idoarad99-jpg/Stickeep-IOT/Documentation/Edge_Cases_List.docx

# Stickeep – רשימת מקרי קצה

רשימת תרחישי קצה שהפרויקט (אפליקציית Flutter + Firebase + חומרת ESP32 עם אישור הגעה ב-NFC/QR) יודע לטפל בהם, כפי שנבדקו לקראת ההגשה הסופית.

# | תרחיש | תוצאה מצופה

1 | ביטול הזמנה שכרגע פעילה על מסך המכשיר (מצב QR/Reserved) | המכשיר חוזר למסך פנוי/idle תוך כ-10 שניות — לא נשאר תקוע על ההזמנה המבוטלת
2 | סריקת כרטיס NFC שגוי (לא תואם להזמנה) | מסך אדום "Card not recognized" למשך 1.5 שניות, ואז חזרה למסך ה-QR — בלי קריסה
3 | סריקת אותו כרטיס NFC פעמיים תוך פחות מ-3 שניות | הסריקה השנייה לא גורמת לקריאה כפולה ל-Cloud Function (cooldown פנימי)
4 | שתי הזמנות סמוכות לאותו מושב (למשל 10:00-11:00 ואז 11:00-12:00) | המכשיר עובר בצורה חלקה בין ההזמנות ב-11:00 — בלי רגע ביניים שמראה "פנוי"
5 | הזמנה שמתחילה תוך 15 דקות אך טרם הגיע זמנה הרשמי | המכשיר כבר מציג QR/Reserved לפני שעת ההתחלה הרשמית (בדיקת חלון הזמן המוקדם)
6 | זמן ההזמנה מסתיים בלי שהסטודנט הגיע | המכשיר חוזר אוטומטית למסך פנוי
7 | ניתוק WiFi בדיוק בזמן ניסיון אישור NFC | ה-Serial Monitor מציג "no WiFi", המסך לא נתקע, ואפשר לנסות שוב לאחר שהחיבור חוזר
8 | הענן לא זמין / שגיאת 500 מה-Cloud Function בזמן אישור | המכשיר מציג הודעת "לא מזוהה" בצורה מבוקרת, בלי קריסה
9 | מפתח API שגוי/לא תקין (401 Unauthorized) | המכשיר מתנהג כמו כרטיס לא תואם — ההודעה למשתמש עדיין הגיונית
10 | הדלקת המכשיר כשאין בכלל חיבור WiFi זמין | לא נתקע לצמיתות, מציג סטטוס "לא מחובר", וממשיך לנסות להתחבר
11 | מספר מושבים/מכשירים בו-זמנית | לכל מכשיר SEAT_ID שונה — אין ערבוב הזמנות בין מכשירים
12 | לחיצה על כפתור העקיפה הידני (test button) במסך QR | מעבר מקומי בלבד למסך "תודה" — בלי קריאה ל-Cloud Function ובלי שינוי סטטוס ב-RTDB/Firestore (לצורכי הדגמה בלבד)
