idoarad99-jpg/Stickeep-IOT/stickeep_app/flutter_01.png

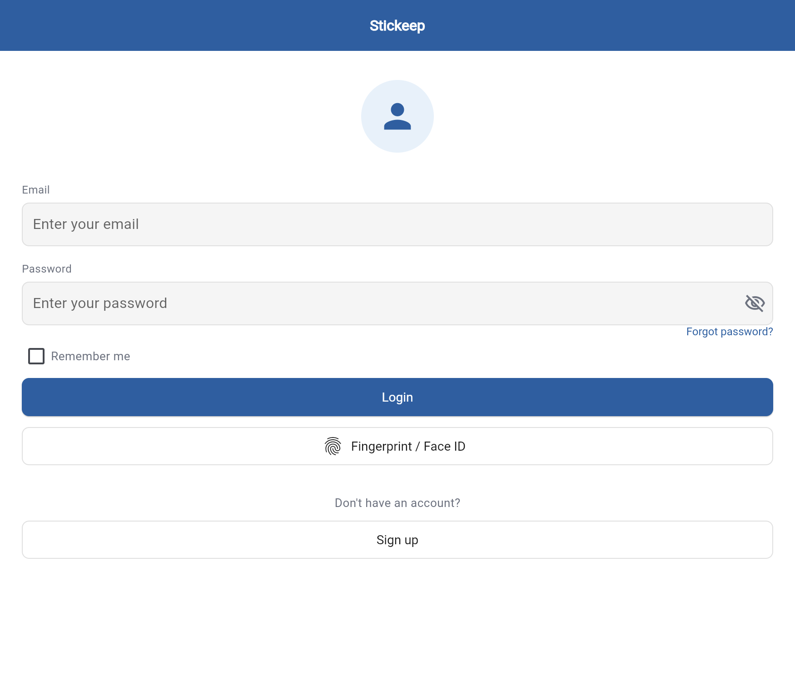
stickeep_app/flutter_01.png
