idoarad99-jpg/Stickeep-IOT/ESP32/QR_image.h

// array size is 10884
static const byte QR_image[] PROGMEM  = {
  0xff, 0xd8, 0xff, 0xe0, 0x00, 0x10, 0x4a, 0x46, 0x49, 0x46, 0x00, 0x01, 0x01, 0x01, 0x01, 0x4a, 
  0x01, 0x4a, 0x00, 0x00, 0xff, 0xdb, 0x00, 0x43, 0x00, 0x03, 0x02, 0x02, 0x02, 0x02, 0x02, 0x03, 
  0x02, 0x02, 0x02, 0x03, 0x03, 0x03, 0x03, 0x04, 0x06, 0x04, 0x04, 0x04, 0x04, 0x04, 0x08, 0x06, 
  0x06, 0x05, 0x06, 0x09, 0x08, 0x0a, 0x0a, 0x09, 0x08, 0x09, 0x09, 0x0a, 0x0c, 0x0f, 0x0c, 0x0a, 
  0x0b, 0x0e, 0x0b, 0x09, 0x09, 0x0d, 0x11, 0x0d, 0x0e, 0x0f, 0x10, 0x10, 0x11, 0x10, 0x0a, 0x0c, 
  0x12, 0x13, 0x12, 0x10, 0x13, 0x0f, 0x10, 0x10, 0x10, 0xff, 0xdb, 0x00, 0x43, 0x01, 0x03, 0x03, 
  0x03, 0x04, 0x03, 0x04, 0x08, 0x04, 0x04, 0x08, 0x10, 0x0b, 0x09, 0x0b, 0x10, 0x10, 0x10, 0x10, 
  0x10, 0x10, 0x10, 0x10, 0x10, 0x10, 0x10, 0x10, 0x10, 0x10, 0x10, 0x10, 0x10, 0x10, 0x10, 0x10, 
  0x10, 0x10, 0x10, 0x10, 0x10, 0x10, 0x10, 0x10, 0x10, 0x10, 0x10, 0x10, 0x10, 0x10, 0x10, 0x10, 
  0x10, 0x10, 0x10, 0x10, 0x10, 0x10, 0x10, 0x10, 0x10, 0x10, 0x10, 0x10, 0x10, 0x10, 0xff, 0xc0, 
  0x00, 0x11, 0x08, 0x00, 0x88, 0x00, 0xf0, 0x03, 0x01, 0x22, 0x00, 0x02, 0x11, 0x01, 0x03, 0x11, 
  0x01, 0xff, 0xc4, 0x00, 0x1d, 0x00, 0x01, 0x00, 0x03, 0x01, 0x00, 0x03, 0x01, 0x01, 0x00, 0x00, 
  0x00, 0x00, 0x00, 0x00, 0x00, 0x00, 0x00, 0x06, 0x07, 0x08, 0x05, 0x01, 0x04, 0x09, 0x03, 0x02, 
  0xff, 0xc4, 0x00, 0x56, 0x10, 0x00, 0x00, 0x04, 0x05, 0x02, 0x02, 0x03, 0x0a, 0x0a, 0x06, 0x06, 
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
  0xbd, 0x56, 0x96, 0x26, 0xa9, 0x93, 0xdc, 0x11, 0xb8, 0xb2, 0x9a, 0x8e, 0x9f, 0x59, 0xe3, 0xd9, 
  0x8c, 0xc5, 0x67, 0xcd, 0x26, 0x12, 0xa5, 0x16, 0x40, 0x8d, 0xdf, 0x12, 0x5b, 0xc6, 0xe0, 0x89, 
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
};
