idoarad99-jpg/Stickeep-IOT/ESP32/Reserved.h

// array size is 8305
static const byte Reserved[] PROGMEM  = {
  0xff, 0xd8, 0xff, 0xe0, 0x00, 0x10, 0x4a, 0x46, 0x49, 0x46, 0x00, 0x01, 0x01, 0x01, 0x01, 0x4a, 
  0x01, 0x4a, 0x00, 0x00, 0xff, 0xdb, 0x00, 0x43, 0x00, 0x03, 0x02, 0x02, 0x02, 0x02, 0x02, 0x03, 
  0x02, 0x02, 0x02, 0x03, 0x03, 0x03, 0x03, 0x04, 0x06, 0x04, 0x04, 0x04, 0x04, 0x04, 0x08, 0x06, 
  0x06, 0x05, 0x06, 0x09, 0x08, 0x0a, 0x0a, 0x09, 0x08, 0x09, 0x09, 0x0a, 0x0c, 0x0f, 0x0c, 0x0a, 
  0x0b, 0x0e, 0x0b, 0x09, 0x09, 0x0d, 0x11, 0x0d, 0x0e, 0x0f, 0x10, 0x10, 0x11, 0x10, 0x0a, 0x0c, 
  0x12, 0x13, 0x12, 0x10, 0x13, 0x0f, 0x10, 0x10, 0x10, 0xff, 0xdb, 0x00, 0x43, 0x01, 0x03, 0x03, 
  0x03, 0x04, 0x03, 0x04, 0x08, 0x04, 0x04, 0x08, 0x10, 0x0b, 0x09, 0x0b, 0x10, 0x10, 0x10, 0x10, 
  0x10, 0x10, 0x10, 0x10, 0x10, 0x10, 0x10, 0x10, 0x10, 0x10, 0x10, 0x10, 0x10, 0x10, 0x10, 0x10, 
  0x10, 0x10, 0x10, 0x10, 0x10, 0x10, 0x10, 0x10, 0x10, 0x10, 0x10, 0x10, 0x10, 0x10, 0x10, 0x10, 
  0x10, 0x10, 0x10, 0x10, 0x10, 0x10, 0x10, 0x10, 0x10, 0x10, 0x10, 0x10, 0x10, 0x10, 0xff, 0xc0, 
  0x00, 0x11, 0x08, 0x00, 0x88, 0x00, 0xf0, 0x03, 0x01, 0x22, 0x00, 0x02, 0x11, 0x01, 0x03, 0x11, 
  0x01, 0xff, 0xc4, 0x00, 0x1d, 0x00, 0x01, 0x00, 0x02, 0x02, 0x03, 0x01, 0x01, 0x00, 0x00, 0x00, 
  0x00, 0x00, 0x00, 0x00, 0x00, 0x00, 0x00, 0x06, 0x07, 0x05, 0x08, 0x01, 0x03, 0x04, 0x09, 0x02, 
  0xff, 0xc4, 0x00, 0x57, 0x10, 0x00, 0x01, 0x03, 0x03, 0x02, 0x03, 0x01, 0x0a, 0x09, 0x07, 0x06, 
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
  0xc5, 0x0c, 0x07, 0x1b, 0x09, 0x59, 0x43, 0xee, 0x92, 0xad, 0x82, 0x10, 0x9c, 0xa5, 0xbf, 0x42, 
  0x32, 0x9b, 0x16, 0xa0, 0xa7, 0x50, 0x6d, 0x39, 0x1d, 0x81, 0xf9, 0x13, 0x2e, 0x37, 0x37, 0x67, 
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
};
