idoarad99-jpg/Stickeep-IOT/ESP32/Thank_you.h

// array size is 11939
static const byte Thank_you[] PROGMEM  = {
  0xff, 0xd8, 0xff, 0xe0, 0x00, 0x10, 0x4a, 0x46, 0x49, 0x46, 0x00, 0x01, 0x01, 0x01, 0x01, 0x4a, 
  0x01, 0x4a, 0x00, 0x00, 0xff, 0xdb, 0x00, 0x43, 0x00, 0x03, 0x02, 0x02, 0x02, 0x02, 0x02, 0x03, 
  0x02, 0x02, 0x02, 0x03, 0x03, 0x03, 0x03, 0x04, 0x06, 0x04, 0x04, 0x04, 0x04, 0x04, 0x08, 0x06, 
  0x06, 0x05, 0x06, 0x09, 0x08, 0x0a, 0x0a, 0x09, 0x08, 0x09, 0x09, 0x0a, 0x0c, 0x0f, 0x0c, 0x0a, 
  0x0b, 0x0e, 0x0b, 0x09, 0x09, 0x0d, 0x11, 0x0d, 0x0e, 0x0f, 0x10, 0x10, 0x11, 0x10, 0x0a, 0x0c, 
  0x12, 0x13, 0x12, 0x10, 0x13, 0x0f, 0x10, 0x10, 0x10, 0xff, 0xdb, 0x00, 0x43, 0x01, 0x03, 0x03, 
  0x03, 0x04, 0x03, 0x04, 0x08, 0x04, 0x04, 0x08, 0x10, 0x0b, 0x09, 0x0b, 0x10, 0x10, 0x10, 0x10, 
  0x10, 0x10, 0x10, 0x10, 0x10, 0x10, 0x10, 0x10, 0x10, 0x10, 0x10, 0x10, 0x10, 0x10, 0x10, 0x10, 
  0x10, 0x10, 0x10, 0x10, 0x10, 0x10, 0x10, 0x10, 0x10, 0x10, 0x10, 0x10, 0x10, 0x10, 0x10, 0x10, 
  0x10, 0x10, 0x10, 0x10, 0x10, 0x10, 0x10, 0x10, 0x10, 0x10, 0x10, 0x10, 0x10, 0x10, 0xff, 0xc0, 
  0x00, 0x11, 0x08, 0x00, 0x87, 0x00, 0xf0, 0x03, 0x01, 0x22, 0x00, 0x02, 0x11, 0x01, 0x03, 0x11, 
  0x01, 0xff, 0xc4, 0x00, 0x1d, 0x00, 0x00, 0x02, 0x03, 0x00, 0x03, 0x01, 0x01, 0x00, 0x00, 0x00, 
  0x00, 0x00, 0x00, 0x00, 0x00, 0x00, 0x00, 0x08, 0x05, 0x06, 0x07, 0x01, 0x02, 0x04, 0x03, 0x09, 
  0xff, 0xc4, 0x00, 0x57, 0x10, 0x00, 0x01, 0x03, 0x03, 0x02, 0x03, 0x03, 0x05, 0x0b, 0x07, 0x08, 
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
  0x05, 0x05, 0x25, 0x01, 0x25, 0x00, 0x2f, 0xb4, 0xe8, 0xf6, 0xc2, 0x5d, 0xe9, 0xba, 0x59, 0xdc, 
  0x48, 0x77, 0x5d, 0xba, 0x2e, 0x13, 0x31, 0x12, 0x64, 0x47, 0x93, 0x45, 0x71, 0xda, 0x76, 0x17, 
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
};
