idoarad99-jpg/Stickeep-IOT/Unit Tests/Image display/IOT_Chair/Main_screen135x240.h

// array size is 6058
static const byte Main_screen135x240[] PROGMEM  = {
  0xff, 0xd8, 0xff, 0xe0, 0x00, 0x10, 0x4a, 0x46, 0x49, 0x46, 0x00, 0x01, 0x01, 0x00, 0x00, 0x01, 
  0x00, 0x01, 0x00, 0x00, 0xff, 0xe2, 0x01, 0xd8, 0x49, 0x43, 0x43, 0x5f, 0x50, 0x52, 0x4f, 0x46, 
  0x49, 0x4c, 0x45, 0x00, 0x01, 0x01, 0x00, 0x00, 0x01, 0xc8, 0x00, 0x00, 0x00, 0x00, 0x04, 0x30, 
  0x00, 0x00, 0x6d, 0x6e, 0x74, 0x72, 0x52, 0x47, 0x42, 0x20, 0x58, 0x59, 0x5a, 0x20, 0x07, 0xe0, 
  0x00, 0x01, 0x00, 0x01, 0x00, 0x00, 0x00, 0x00, 0x00, 0x00, 0x61, 0x63, 0x73, 0x70, 0x00, 0x00, 
  0x00, 0x00, 0x00, 0x00, 0x00, 0x00, 0x00, 0x00, 0x00, 0x00, 0x00, 0x00, 0x00, 0x00, 0x00, 0x00, 
  0x00, 0x00, 0x00, 0x00, 0x00, 0x00, 0x00, 0x00, 0x00, 0x01, 0x00, 0x00, 0xf6, 0xd6, 0x00, 0x01, 
  0x00, 0x00, 0x00, 0x00, 0xd3, 0x2d, 0x00, 0x00, 0x00, 0x00, 0x00, 0x00, 0x00, 0x00, 0x00, 0x00, 
  0x00, 0x00, 0x00, 0x00, 0x00, 0x00, 0x00, 0x00, 0x00, 0x00, 0x00, 0x00, 0x00, 0x00, 0x00, 0x00, 
  0x00, 0x00, 0x00, 0x00, 0x00, 0x00, 0x00, 0x00, 0x00, 0x00, 0x00, 0x00, 0x00, 0x00, 0x00, 0x00, 
  0x00, 0x00, 0x00, 0x00, 0x00, 0x00, 0x00, 0x00, 0x00, 0x09, 0x64, 0x65, 0x73, 0x63, 0x00, 0x00, 
  0x00, 0xf0, 0x00, 0x00, 0x00, 0x24, 0x72, 0x58, 0x59, 0x5a, 0x00, 0x00, 0x01, 0x14, 0x00, 0x00, 
  0x00, 0x14, 0x67, 0x58, 0x59, 0x5a, 0x00, 0x00, 0x01, 0x28, 0x00, 0x00, 0x00, 0x14, 0x62, 0x58, 
  0x59, 0x5a, 0x00, 0x00, 0x01, 0x3c, 0x00, 0x00, 0x00, 0x14, 0x77, 0x74, 0x70, 0x74, 0x00, 0x00, 
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
  0x4f, 0x4f, 0x4f, 0x4f, 0x4f, 0x4f, 0x4f, 0x4f, 0x4f, 0x4f, 0x4f, 0x4f, 0x4f, 0x4f, 0x4f, 0x4f, 
  0x4f, 0x4f, 0x4f, 0x4f, 0x4f, 0x4f, 0x4f, 0x4f, 0xff, 0xc0, 0x00, 0x11, 0x08, 0x00, 0x87, 0x00, 
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
};
