idoarad99-jpg/Stickeep-IOT/Unit Tests/Image display/IOT_Chair/jpeg5.h

// array size is 6734
static const byte northn_lights[] PROGMEM  = {
  0xff, 0xd8, 0xff, 0xe0, 0x00, 0x10, 0x4a, 0x46, 0x49, 0x46, 0x00, 0x01, 0x01, 0x01, 0x00, 0x60, 
  0x00, 0x60, 0x00, 0x00, 0xff, 0xe1, 0x0b, 0xf6, 0x45, 0x78, 0x69, 0x66, 0x00, 0x00, 0x4d, 0x4d, 
  0x00, 0x2a, 0x00, 0x00, 0x00, 0x08, 0x00, 0x01, 0x01, 0x12, 0x00, 0x03, 0x00, 0x00, 0x00, 0x01, 
  0x00, 0x01, 0x00, 0x00, 0x00, 0x00, 0x00, 0x1a, 0x00, 0x06, 0x01, 0x03, 0x00, 0x03, 0x00, 0x00, 
  0x00, 0x01, 0x00, 0x06, 0x00, 0x00, 0x01, 0x1a, 0x00, 0x05, 0x00, 0x00, 0x00, 0x01, 0x00, 0x00, 
  0x00, 0x68, 0x01, 0x1b, 0x00, 0x05, 0x00, 0x00, 0x00, 0x01, 0x00, 0x00, 0x00, 0x70, 0x01, 0x28, 
  0x00, 0x03, 0x00, 0x00, 0x00, 0x01, 0x00, 0x02, 0x00, 0x00, 0x02, 0x01, 0x00, 0x04, 0x00, 0x00, 
  0x00, 0x01, 0x00, 0x00, 0x00, 0x78, 0x02, 0x02, 0x00, 0x04, 0x00, 0x00, 0x00, 0x01, 0x00, 0x00, 
  0x0b, 0x75, 0x00, 0x00, 0x00, 0x00, 0x00, 0x00, 0x00, 0x60, 0x00, 0x00, 0x00, 0x01, 0x00, 0x00, 
  0x00, 0x60, 0x00, 0x00, 0x00, 0x01, 0xff, 0xd8, 0xff, 0xdb, 0x00, 0x43, 0x00, 0x08, 0x06, 0x06, 
  0x07, 0x06, 0x05, 0x08, 0x07, 0x07, 0x07, 0x09, 0x09, 0x08, 0x0a, 0x0c, 0x14, 0x0d, 0x0c, 0x0b, 
  0x0b, 0x0c, 0x19, 0x12, 0x13, 0x0f, 0x14, 0x1d, 0x1a, 0x1f, 0x1e, 0x1d, 0x1a, 0x1c, 0x1c, 0x20, 
  0x24, 0x2e, 0x27, 0x20, 0x22, 0x2c, 0x23, 0x1c, 0x1c, 0x28, 0x37, 0x29, 0x2c, 0x30, 0x31, 0x34, 
  0x34, 0x34, 0x1f, 0x27, 0x39, 0x3d, 0x38, 0x32, 0x3c, 0x2e, 0x33, 0x34, 0x32, 0xff, 0xdb, 0x00, 
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
  0x33, 0x52, 0xf0, 0x15, 0x62, 0x72, 0xd1, 0x0a, 0x16, 0x24, 0x34, 0xe1, 0x25, 0xf1, 0x17, 0x18, 
  0x19, 0x1a, 0x26, 0x27, 0x28, 0x29, 0x2a, 0x35, 0x36, 0x37, 0x38, 0x39, 0x3a, 0x43, 0x44, 0x45, 
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
};
