idoarad99-jpg/Stickeep-IOT/(commit log)

2026-06-06 Add home screen, admin panel, role-based access, login flow
2026-06-10 feat: add temporary Admin Panel button on home screen for testing
2026-06-10 feat: build success screen, fix seat availability per time slot
    - success_screen: full UI with bouncing dog, info card, navigation
    - seat_map_screen: replace RTDB global status with Firestore query
    filtered by classroom + date + time slot so seats only show as
    taken for the specific slot being booked
    - confirm_screen: write reservation to Firestore instead of RTDB,
    remove seatsRef param
    - reservations_screen: add stub
2026-06-10 feat: add scan-on-arrival button and live next reservation card
    - success_screen: add "Scan on arrival" button navigating to ScannerScreen
    - confirm_screen: capture reservationId, store lessonName, pass studentName
    - home_screen: replace static card with Firestore StreamBuilder showing
    nearest upcoming reservation with lesson, seat, time, and date tag
2026-06-10 feat: report_screen + home button
2026-06-10 feat: include studentNumber in reservation document
    Reads studentNumber from students/{uid} in Firestore before writing the reservation to Realtime Database, so the ESP32 can display it on the sticker LED directly from the reservation record.
2026-06-10 feat: add Firestore reservation write with studentNumber and lessonName
    Booking now writes to both Realtime Database (ESP32 seat control) and
    Firestore reservations/ (home screen next-reservation card + scanner).
    Firestore doc includes studentNumber (read from students/{uid}) so the
    ESP32 can display it on the sticker LED. reservationId passed to
    SuccessScreen/ScannerScreen is now the Firestore doc ID.
2026-06-10 feat: add Scan sticker on arrival button to home screen
    Queries Firestore for an active (status=reserved) reservation for the
    current user. If found, navigates to ScannerScreen with classroom,
    studentName, and Firestore reservationId. If none, shows a snackbar.
2026-06-10 feat: add Firestore seats collection for IoT sticker integration
    New seats/{seatId} structure (ESP32 reads status/studentNumber/time):
    - On reservation: writes seat doc + reservations subcollection
    - On scan arrival: updates seat status to occupied
    - On cancel: clears seat doc and marks subcollection entry cancelled
    Seat ID mapping (SEAT_T{n}_{seat}): Taub 1–5, seats 1–4 per classroom.
    Seat map screen now reads sticker seats (1–4) from Firestore filtered
    by date+time, so different time slots correctly show as free.
2026-06-10 fix: confirm screen - early studentNumber read, subcollection duplicate check, classroomId in seat doc
    - Read students/{uid} immediately after uid check so studentNumber
    is guaranteed loaded before any writes (fixes empty string issue)
    - Replace duplicate reservation check with seats/{seatId}/reservations
    subcollection query filtered by exact date+startTime+endTime+status,
    so only the same time slot is blocked (not different slots on same seat)
    - Add classroomId field to seats/{seatId} document for ESP32/admin reads
2026-06-17 fix: real camera scanner, remove QR display from success screen, fix apiKey
    - scanner_screen: replace ValueListenableBuilder spinner with explicit
    controller.start() + 5s timeout; track cameraReady/cameraError in state;
    add debugPrint at every lifecycle step; remove simulate button
    - success_screen: remove QrImageView and label (reservationId still passed internally)
    - main.dart: fix Firebase apiKey case typo (SpVQLY -> SPVQlY)
2026-06-20 Fix studentNumber bug, fix seat availability check, add QR code dialogs, fix camera scanner
2026-06-25 cancelled res will be deleted and showed as cancelled in res history, filter res history by deleted and past, show in my res on the upcoming res, changes in admin panel- searching students by name an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
2026-07-02 feat: display student ID and NFC status in reservation cards
    - add studentNumber + nfcStatus fields to Reservation model
    - show 'ID XXXXXXXX' row in ReservationCard when studentNumber present
    - show nfc badge (pending/approved/declined) when nfc_status set by ESP32
    - show Student ID in home screen Next Reservation card
2026-07-02 feat: sort reservations by date+time ascending, add sort_key to RTDB
    - confirm_screen writes numeric sort_key (YYYYMMDDHHММ) to RTDB
    so ESP32 can also query reservations in order directly from Firebase
    - reservations_screen sorts by date+time combined (nearest first)
    - home_screen Next Reservation card sorts by date+time combined
2026-07-06 Add NFC serial number field to signup, admin approval flow, and real-time NFC status badge
2026-07-06 Add forgot password flow, real-time battery/last-seen in seat map, and sticker monitor in admin panel
2026-07-08 fix: show username in scanner, hide scan button after confirmation, skip confirmed reservations in Next Reservation
2026-07-08 fix: detail_screen uses cancelReservation helper; signup validates student ID; hide scan button after confirmation
2026-07-08 fix: remove biometric button (not supported on web)
2026-07-08 chore: remove debug print statements and unused imports
2026-07-08 Fix classroom loading spinner, NFC colon formatting, and student ID display
    Classroom dropdown hung forever when the Firestore query errored (e.g.
    missing composite index) since the StreamBuilder never checked
    snapshot.hasError; now falls back to a hardcoded classroom list on error
    or after a 5s timeout. Also save nfcSerialNumber to seats/{seatId} in
    colon-separated format for the ESP32 hardware, and fix a literal
    "${widget.studentNumber}" string on the success screen.
2026-07-08 fix: classroom picker query needed a composite index that doesn't exist
    .where('active', isEqualTo: true).orderBy('order') requires a composite
    Firestore index (equality + orderBy on a different field) - zero composite
    indexes exist on this project, so the query threw FAILED_PRECONDITION,
    silently triggering the hardcoded Taub-1..5 fallback list on every load.
    This is the same class of bug fixed in seat_map_screen.dart previously,
    reintroduced here by the merge that brought back the loading-fallback
    logic on the old query shape.
    Filtering 'active' client-side instead avoids needing the index. Also
    surface the actual error text in the fallback UI so this is visible
    on-screen next time instea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
2026-07-09 feat: report screen adds location fields; admin reports shows name + resolve button
2026-07-09 feat: auto-expire no-show reservations after 30min; live reports count; filter chips in reports
2026-07-09 feat: soft/modern visual overhaul, dashboard home, dark mode, transitions
    - Softer theme: larger radii, subtle card shadows via new AppCard widget,
    refined light+dark palettes.
    - Dark mode: AppColors becomes reactive (ThemeController-driven), with a
    toggle on the home screen and persisted preference.
    - Home screen rebuilt as a dashboard: gradient greeting header, restyled
    next-reservation card, 2x2 quick-action grid with icon tiles.
    - Smooth fade+slide page transitions app-wide via a shared AppPageRoute,
    replacing the default platform MaterialPageRoute everywhere.
    - Consistent EmptyState widget (icon + title + subtitle) applied to
    reservations, reports, and seat map empty states; s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
2026-07-09 fix: dashboard icon size + design/UX pass across admin screens
    - Dashboard quick-action icons: revert oversized squares back to
    original 40px, just make the icon inside bigger (22->26) and
    centered, per feedback.
    - Seat map rows: soft shadow + animated selection state, wheelchair
    icon in a circle instead of a raw emoji.
    - All users / pending users / admin home: several admin screens had
    hardcoded colors (no dark mode) and unusually tiny 7-9px text left
    over from before the theme system existed. Rewired them onto
    AppColors/AppCard/EmptyState and brought text sizes in line with
    the rest of the app.
2026-07-09 feat: redesign login/signup with gradient header; tune dashboard icons
    - Dashboard quick-action icons: smaller squares (40->34), bigger icon
    inside (26->24 but higher fill ratio), centered.
    - Login/signup screens: gradient header matching the dashboard's
    visual language (icon badge, title, tagline), form moved into a
    clean section below instead of a plain flat scaffold. Signup's
    avatar picker now lives in the header with a back button.
2026-07-09 Group reservations by date, extend loading skeletons, add haptics + high contrast mode
    - Group upcoming reservations into Today/Tomorrow/This week/Later sections
    with headers in reservations_screen.dart.
    - Extend the shimmer skeleton pattern (AdminListSkeleton) to every admin
    list screen and the seat map that previously showed a bare spinner.
    - Add haptic feedback at the key moments a low-vision/motor-impaired user
    benefits from tactile confirmation: seat selection, booking confirmed,
    arrival scan success/failure, and every cancellation path.
    - Add a high-contrast accessibility mode (third option alongside dark mode
    and colorblind mode): darker secondary text, thicker card/input/bu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
2026-07-09 Screen-reader semantics audit: add missing tooltips and labels
    - Add tooltips to icon-only buttons that had none (back button, password
    visibility toggles, home nav buttons, sign-out) so screen readers
    announce their purpose instead of just "button".
    - Wrap the tappable avatar/photo-picker on the signup screen in a
    Semantics(button: true, label: 'Add profile photo') since it has no
    text child for Flutter to infer a label from.
    - Admin edit/delete/restore icon buttons and text-labeled selectors
    (building/room chips, tag filters) already had adequate semantics —
    left as-is.
2026-07-09 Fix arrival scan showing raw uid instead of student name
    reservations_screen.dart's "scan arrival" button passed the signed-in
    user's uid as studentName to ScannerScreen, so the "Welcome to X, ...!"
    message showed a Firebase uid instead of the student's actual name.
    Fetch the name from students/{uid} once on screen load instead, and make
    the welcome text degrade gracefully if it's ever empty. Also removed a
    dead, unused local variable of the same name in home_screen.dart.
2026-07-09 Remove dead biometric-login stub
    _onBiometricPressed was declared but never wired to any button — no
    local_auth dependency exists either, so this was unreachable dead code,
    not a live broken UI element.
2026-07-10 Fix: allow unauthenticated reads on seats/{seatId}/reservations
    The Firestore rules deployed earlier this session broke every physical
    ESP32 seat display: reviewing Ido's actual firmware (FirebaseManager.ino)
    shows it polls GET .../seats/{seatId}/reservations every 10s via a plain
    HTTPClient request with no Firebase Auth at all, and never writes back to
    Firebase. Confirmed broken with a live curl (403 permission-denied) before
    this fix, and working (200 + data) after. Writes to this subcollection
    still require sign-in — only the read was loosened, and only for this one
    subcollection the hardware actually depends on.
2026-07-10 Add confirmNfcArrival Cloud Function for future NFC hardware arrival flow
    Not deployed yet — project is still on the Spark plan, which doesn't
    support Cloud Functions (needs Blaze). Written now so it's ready the
    moment the plan is upgraded and Ido's team has NFC hardware to call it.
    Mirrors what scanner_screen.dart's QR-based arrival confirmation already
    does (mark seat/reservation occupied, RTDB status: occupied), but for a
    device with no Firebase Auth: gated by a shared x-device-key header
    instead, matches the scanned card against seats/{seatId}.nfcSerialNumber,
    and writes nfc_status ('approved'/'declined') to the RTDB reservation
    entry that reservation_card.dart's live badge already li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
2026-07-10 Add getSeatReservations read-proxy Cloud Function (not yet in use)
    Lower-priority hardening item: lets the seat display's reservation poll
    go through a trusted server endpoint instead of Firestore directly, so
    the seats/{seatId}/reservations rule can eventually go back to
    signed-in-only with no public exception. Also returns a flat JSON shape
    instead of Firestore's verbose fields.stringValue REST format, simplifying
    the firmware's parsing too.
    Not wired up yet — DO NOT tighten the Firestore rule until Ido's firmware
    is actually switched to call this instead of Firestore directly, or every
    seat display breaks again the same way the original rules deploy did.
2026-07-10 Add Ido's ESP32 seat-display firmware to the repo
    Source files from Ido (received 2026-07-10): the working sketch that
    polls Firestore for a seat's reservations and drives the TFT display's
    main/QR-prompt/thank-you/reserved states. Renamed four image headers
    that arrived as .txt (file-sharing likely blocked .h attachments) back
    to their real extensions to match what IOT_Chair_20_6.ino #includes.
    Now under version control instead of sitting in a Downloads folder, so
    both teams can actually collaborate on it with real history.
2026-07-10 Move unrelated speech-to-text prototype files out of ESP32/
    SECRETS.h, parameters.h, compiled_program.bin were for an earlier,
    different prototype (mic + keypad + Google Cloud Speech API), not the
    seat-display firmware that now lives in ESP32/. Moved to archive/ so
    they stop looking like part of the current firmware.
2026-07-10 Fix P0 firmware bugs, add real QR rendering, WiFi provisioning, and NFC
    Software-side work on the seat-display firmware ahead of the submission
    deadline, per the priority list shared with the hardware team:
    - FirebaseManager.ino: skip cancelled reservations (status was fetched
    but never checked, so a cancelled booking still blocked the seat as
    reserved), fetch qrToken per reservation, track consecutive sync
    failures.
    - StateManager.ino: use the qrToken to drive the new QR screen, poll for
    NFC card taps alongside the existing (now explicitly local-only,
    non-authoritative) manual button override.
    - DisplayManager.ino: render a real QR code encoding the active
    reservation's ID (via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
    [DisplayManager.ino, FirebaseManager.ino, NfcManager.ino, StateManager.ino, TimeManager.ino, WifiManager.ino]
2026-07-10 Widen main-screen slot grid to full day, add seat provisioning doc
    - DisplayManager.ino: the main screen's reservation grid was fixed to
    8:30-16:30 in 1-hour blocks, so any reservation outside that window
    (real test data includes evening bookings like 20:25-21:35) showed up
    nowhere, making an occupied seat look free. Widened to 8:00-24:00 in
    2-hour blocks instead. A fully data-driven version (real classroom
    operating hours from Firestore) would need a new schema field and is
    out of scope before the deadline; this closes the actual display bug
    with a minimal, low-risk change.
    - PROVISIONING.md: step-by-step checklist for flashing a new physical
    seat unit with the correct SEAT_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
    [DisplayManager.ino]
2026-07-10 Add Wokwi simulator config for visualizing firmware without hardware
    diagram.json wires a generic ESP32 devkit to an ILI9341 display and an
    MFRC522 NFC reader (matching the firmware's actual GPIO assignments:
    SS=5/RST=27 for NFC, button on 15). Chose ILI9341 as a stand-in for the
    real ST7789 display since I verified directly in Wokwi's live part
    picker that ST7789 isn't a supported native part (zero search results),
    while ILI9341 + TFT_eSPI is confirmed working via a real example project.
    README.md documents what's confirmed vs. inferred (exact ILI9341 pin
    names on Wokwi's part weren't independently verified) and walks through
    getting TFT_eSPI to target the simulation's ILI9341 without touc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
2026-07-12 Add Web NFC tap-to-scan for NFC card registration (Chrome/Android only)
    Manual entry required students to install a separate NFC-reader app and
    copy-paste a hex UID during signup — a real accessibility barrier for an
    app built for users with disabilities. Adds a "Tap your card" button using
    the Web NFC API (dart:js_interop) that reads the card directly and fills
    the field automatically.
    Feature-detected via 'NDEFReader' in window — only Chrome on Android
    supports this API. Every iOS browser (including Chrome) runs on WebKit
    per Apple's platform requirement, and WebKit has never implemented Web
    NFC, so there's no browser-based fix for iOS; manual entry remains as the
    fallback there and o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
2026-07-13 Add adapted OLED+PN532 firmware variant (separate from TFT+MFRC522)
    Talia's independent sketch had a different but compatible goal — same
    NFC arrival confirmation, different hardware (SSD1306 OLED + PN532 over
    I2C, vs TFT + MFRC522 over SPI). Kept her hardware choices, fixed the
    architecture issues found on review:
    - Removed a hardcoded WiFi password (a real personal hotspot credential)
    committed in source, replaced with the same captive-portal provisioning
    (plain + eduroam) as the TFT variant.
    - The original PATCHed nfc_status directly to Firestore, unauthenticated
    — this fails under the deployed security rules (writes require
    sign-in, which this device can never have). Replace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
2026-07-13 Fix two real compile errors found by actually compiling the TFT firmware
    Set up a full ESP32 Arduino toolchain (arduino-cli + esp32 core + every
    required library) to actually verify this compiles, instead of just
    reading it — found two genuine bugs:
    1. #include <qrcode.h> was silently resolving to the ESP32 core's own
    bundled qrcode.h (from Espressif's WiFi-provisioning component, a
    completely different, incompatible API) instead of the "QRCode"
    library by Richard Moore this code actually needs — both libraries
    ship a header with the exact same filename. Fixed by vendoring
    Richard Moore's two files directly into the sketch as StickeepQrGen.h/
    .c, which Arduino always s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
    [NfcManager.ino]
2026-07-13 Switch ESP32 firmware to TTGO T-Display + PN532 (I2C)
    Hardware team is moving to the TTGO T-Display board, keeping the same
    PN532 reader. TTGO's screen pins are fixed (4/5/16/18/19/23), which
    collided with the old MFRC522 SS pin, so NFC now runs over I2C
    (GPIO 21/22) instead of SPI. NfcManager.ino ported to the PN532
    library API already proven in ESP32_OLED_PN532.ino, with a scan-attempt
    throttle added so the reader's blocking read doesn't stall WiFi/Firebase
    polling in loop(). External function signatures unchanged. Verified
    with a real arduino-cli compile (exit 0, 97% flash).
    [NfcManager.ino]
2026-07-13 Temporarily revert WiFi to hardcoded SSID/password
    The captive-portal provisioning AP wasn't showing up reliably during
    hardware testing under time pressure ahead of submission. Reverting
    connectToWiFi()/reconnect to a direct WiFi.begin() call with fixed
    credentials, matching how it worked before the provisioning feature.
    Fill in HARDCODED_WIFI_SSID/PASSWORD in WifiManager.ino before flashing.
    [WifiManager.ino]
2026-07-13 Detect remote QR arrival confirmation while parked on QR_SCAN screen
    updateStateMachine() only checked NFC taps and the manual override
    button while in STATE_QR_SCAN, never the reservation status Firestore
    already reported — so a student confirming arrival via the app's QR
    scanner updated RTDB/Firestore correctly but the seat screen never
    advanced to the Thank You screen. Now checks resStatus[] (refreshed
    every ~10s by updateReservationsFromFirebase) for the active
    reservation going to "occupied" and transitions accordingly.
    [StateManager.ino]
2026-07-13 Fix admins unable to view other students' reservations
    reservations/{uid} RTDB read/write rules checked
    root.child('students').child(auth.uid).child('role') — but the students
    collection only exists in Firestore, never mirrored into RTDB, so that
    check was always null/false and only the owning user's own reservations
    were ever readable. Admin's "Search users" -> reservations view looked
    empty for every user but themselves.
    Fixed with an admins/{uid} mirror in RTDB: mirrorAdminRole (Firestore
    trigger on students/{uid}) keeps it in sync going forward whenever
    all_users_screen.dart promotes someone to admin; backfillAdminMirror
    (one-time HTTPS endpoint, gated by the existing DEVICE_API_KEY s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
2026-07-13 Clean up junk files and stale comments before sharing repo with instructors
    - Remove .DS_Store (tracked by mistake), flutter_app/ (empty first-attempt
    scaffold text files), archive/speech-to-text-prototype/ (abandoned,
    unrelated prototype with an empty placeholder binary), and an empty
    0-byte junk file under Unit Tests/.
    - Add .DS_Store and stickeep_app/.firebase/ to .gitignore so they don't
    get re-added.
    - Remove dead commented-out code in BatteryManager.ino referencing a
    calculateBatteryPercent() function that was never implemented.
    - Replace a real personal WiFi network name hardcoded in an old unit-test
    sketch (Unit Tests/WiFi_test/ESP_tutorial3.ino) with a placeholder —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
    [ESP_tutorial3.ino]
2026-07-13 Remove battery code and empty Documentation/ folder
    Battery sensing isn't part of the course requirements — the device is
    USB-powered from a computer, no battery hardware exists. Removes
    BatteryManager.ino entirely and its status-bar rendering/loop call.
    Also removes Documentation/ (only empty placeholder files, nothing to
    lose), and commits functions/package-lock.json (legitimate lockfile
    that was sitting uncommitted, unrelated to this cleanup).
2026-07-14 Add connection diagram, library versions, and edge-cases doc
    Per the course's final-submission requirements: connection diagram,
    library/SDK versions, and a printable edge-cases list (Word doc, 3
    copies required at submission).
2026-07-14 Fix blurry QR scanner camera preview on web
    MobileScannerController() was created without an explicit
    cameraResolution, so on web the browser's getUserMedia call had no
    width/height constraint and defaulted to a low resolution (commonly
    640x480), which then gets stretched to fill the preview box — blurry
    regardless of the phone's actual camera quality. Requesting 1280x720
    explicitly fixes this.
2026-07-15 Add single WS2812/SK6812 status LED
    Wiring: DIN -> GPIO25, VDD -> 5V, GND -> GND (DOUT unused, single LED).
    Uses Adafruit NeoPixel. Color mapping:
    - solid blue: seat free
    - blinking blue: reservation upcoming/active, awaiting arrival
    - green flash: NFC/QR arrival confirmed
    - red blink: NFC card didn't match
    - solid red (highest priority): WiFi/communication fault
    Note: a wrong QR scan can't be shown here since that mismatch is
    detected entirely in the phone app (scanner_screen.dart) and never
    reaches the device — only NFC mismatches are visible to the firmware.
    [StateManager.ino]
2026-07-15 Only call NeoPixel show() on actual color changes; add NFC debug logs
    statusLed.show() was being called on every loop() iteration regardless
    of whether the color changed. It briefly disables interrupts to
    bit-bang precise timing to the LED, and doing that constantly appears
    to have disrupted the PN532's I2C reads (reported: NFC scanning and LED
    color changes both stopped working after adding the LED). Now only
    calls show() when the target color actually differs from what's
    already applied.
    Also logs the PN532 firmware version on successful init, and clarifies
    the failure message, to make this kind of issue easier to diagnose
    from Serial Monitor next time.
    [NfcManager.ino]
2026-07-15 Switch status LED from WS2812 assumption to actual common-anode RGB LED
    Turns out the physical component is a discrete 4-leg common-anode RGB
    LED (confirmed: it lit up when the long/common leg was wired to VCC),
    not an addressable WS2812/SK6812 — completely different protocol (3
    PWM pins, active-low, no data line) rather than a single-wire NeoPixel
    signal. That mismatch is why the color never changed regardless of the
    earlier show()-frequency fix: the wrong driver was being used entirely.
    New wiring: COM -> 5V, R -> GPIO25, G -> GPIO26, B -> GPIO27 (through
    each color's inline resistor). setLedColor() inverts 0-255 brightness
    values since common-anode pins are active-low. Same color mappi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
2026-07-15 Rework LED color mapping: green=free, blue=occupied
    - Free: solid green (was blue)
    - Occupied: solid blue (was yellow)
    - Arrival confirmed: blinking green for 3s (was solid green for 1.5s)
    - Awaiting arrival (15min window): blinking blue — unchanged
    - NFC mismatch: blinking red for 1.5s — unchanged
    - WiFi/comm fault: solid red, highest priority — unchanged
2026-07-15 Fix red decline blink never appearing on wrong NFC card
    drawNfcDeclined() held the red error screen with a blocking
    delay(1500) — that froze loop() for the whole window, so
    updateLedState() never ran again until after the LED's own decline
    event had already silently expired. Replaced with a wait loop that
    calls updateLedState() every 50ms, so the red blink actually renders
    in sync with the on-screen decline message.
    [DisplayManager.ino]
2026-07-16 Update SETUP_NOTES.md: LED wiring, hardcoded WiFi, flash usage
    Was still describing the captive-portal WiFi flow as active (it isn't
    — see the earlier hardcoded-credentials revert) and didn't mention the
    new status LED at all. Also refreshed the flash usage percentage and
    added LED-aware expectations to the test plan.
2026-07-16 Fix high-contrast text and add screen-reader labels to booking flow
    High contrast: several muted white texts/icons (scanner error screen,
    seat-map AppBar subtitle) were hardcoded to Colors.white70/white54,
    completely bypassing the high-contrast toggle since they never went
    through AppColors. Added AppColors.whiteMuted/whiteFaint (full white
    when high contrast is on) and switched those call sites over.
    Screen reader: bare GestureDetector (no Semantics, unlike InkWell/
    buttons elsewhere) was used for the core interactive controls in the
    booking flow — classroom/building/room chips, date/time pickers in
    classroom_screen.dart, and seat tiles in seat_map_screen.dart — so none
    of them announc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
2026-07-20 Fix QR scanner camera focus, add zoom slider and torch button
2026-07-21 Revert "Fix QR scanner camera focus, add zoom slider and torch button"
    This reverts commit d2742eb798614cb4a569ef1a1fe274aa76f64a88.
2026-07-21 Redo Marom's native-camera QR scan fix with a compatible image version
    Reverted this approach earlier because image ^4.9.1 required xml ^7.0.1,
    which needs Dart SDK ^3.11.0 — incompatible with this project's SDK
    (3.4.1), so `flutter pub get` failed outright for anyone but Marom
    (who had a stale local lock file already resolved).
    The underlying diagnosis was correct, though: mobile_scanner's web
    implementation has no autofocus control at all, which is exactly why
    scanning was hard. Handing off to the phone's native camera app via
    image_picker (which has real autofocus) is the right fix — just needed
    image: ^4.2.0 instead, which resolves cleanly.
    Also fixed a real bug in the manual QR de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
2026-07-21 Revert "Redo Marom's native-camera QR scan fix with a compatible image version"
    This reverts commit e1a0b843486b49eaa781cd26aaa6c550340f5bb5.
2026-07-21 Remove ESP32/wokwi/ - not used, real hardware backup video used instead
2026-07-21 Fill in blank/stale READMEs and clarify confusing admin-panel code
    - Root README.md was still the fully unfilled course template
    ("XXXXX Project by:", placeholder folder list referencing
    directories that don't exist in this repo like flutter_app/
    Parameters/ Assets/) — replaced with the real project description,
    actual folder list, and pointers to Documentation/.
    - stickeep_app/README.md was still the default `flutter create`
    boilerplate ("A new Flutter project") — replaced with real run/build
    instructions and a structure overview.
    - pubspec.yaml description was also still the default placeholder.
    - PROVISIONING.md described the WiFi captive-portal flow as the active
    provis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
2026-07-21 Remove stray misplaced/stale comment in TimeManager.ino
    Described WifiManager.ino's eduroam support, sitting at the top of the
    wrong file, and referenced provisioning behavior that's no longer active.
    [TimeManager.ino]
2026-07-21 Remove backfillAdminMirror from source (already deleted from prod)
    Served its purpose — one-time backfill of the admins/ RTDB mirror for
    admins promoted before mirrorAdminRole existed.
2026-07-22 Remove duplicate IOT_Chair_20_6/ folder
    Ido's Arduino IDE upload created a full duplicate copy of the ESP32/
    firmware (including stale versions predating the TimeManager.ino fix
    and the wokwi/ removal). The real, current firmware lives in ESP32/.
    [DisplayManager.ino, FirebaseManager.ino, JpegFunctions.ino, Main_screen135x240.h, NfcManager.ino, QR_image.h, Reserved.h]
